JorgeMarinN/TORepo_IHPSept2025_FloatingGateDCDC/README.md

# TORepo_IHPSept2025_FloatingGateDCDC
Floating gate DCDC project for the Sept. 2025 IHP tapeout
