JorgeMarinN/TORepo_IHPSept2025_FloatingGateDCDC/Documentos/3.- Thin_Gate_Oxide_CMOS_DC-DC_Buck_Converter_with_Floating_Gate_Drivers (1).pdf

# Thin gate oxide CMOS DC-DC Buck converter with floating gate drivers

Joel Gak³

, Jorge Marin¹,2

, Nicolas Gonzalez³

, Daniel Arevalos¹

,Nicolas Calarco³

, Matias Miguez³
,
Alfonso Cortes¹

, Vicente Osorio¹

, Mario Romero¹

, Christian A. Rojas¹,2
1Department of Electronic Eng., Universidad Tecnica Federico Santa Maria, Valparaiso, Chile,
2Advanced Center of Electrical and Electronics Engineering, Universidad Tecnica Federico Santa Mar ´ | ´ıa,
{jorge.marinn,christian.rojas}@usm.cl
3Engineering Department, Universidad Catolica del Uruguay, Montevideo, Uruguay, ´ | {jgak,mmiguez}@ucu.edu.uy

Abstract—This document is a model and instructions for LATEX.
This work focuses on the design of a CMOS DC-DC buck converter targeting input voltages higher than the limited gatesource voltage common in thin oxide technology. This is enabled by driving the power device gates using fully integrated circuitry which allows floating voltages in the high-side device using bootstrapping. The gate driver has been fully characterized in simulation, showing low to high an high to low times below 12ns. The bootstrapped level shifter has been integrated together with a dual-NMOS half bridge using the Skywater 130nm Opensource CMOS technology. Simulations show a peak efficiency of 91% at 38.2mA current load for a 10V to 3.3V DC-DC conversion, extending the input voltage range previously reported in this technology by 2X.
Index Terms—Thin Oxide, CMOS, floating gate
I. INTRODUCTION

DC-DC converters are an essential component of many modern electronic devices like, smartphones, laptops, and tablets. Their importance is increased when of the grid edge computing devices for Internet of thing applications are taken into account. In power management systems, DC-DC converters are used, switching from one DC voltage level to another, which is often necessary to power different components in a device or to match the voltage requirements of a load to the available power supply [1]. DC-DC converters can be implemented using a variety of technologies, but CMOS technology is becoming increasingly popular for this application. CMOS transistors have a number of advantages for DC-DC converters, such as high switching speed, low power consumption, ability to withstand high voltages (HV) in source and drain without complex extra process and high-density integration allowing high complex digital to be integrated beside HV circuits [2]. In Fig.1 a single leg NMOS DC-DC Buck converter is shown, transistors M1,2 are used as power switches to transfer energy to inductance L0 where the switching is performed by the drivers Driv1, −Driv2. In order to reduce as much as possible the rON of the transistor M1,2, VGS must be as high as possible without breaking (VMAX). In case of transistor M1 the ideal switching voltage will be just VMAX but for M2 the

The authors would like to thanks ANII for the post doctoral funding of Nicolas Calarco project number PD NAC 2021 1 168336. Supported by the Chilean research grant ANID/FONDECYT Regular/1210757 and by AC3E (ANID/BASAL/FB0008).

switching voltage will be VMAX + VS1, which could causes gate rupture in standard CMOS technologies due to thin gate oxide leading to transistor failure.
Even though in some technologies it is possible to fabricate CMOS transistors with thicker gate oxides, this is generally more expensive to fabricate and not generally available. This work addresses the challenge of using standard CMOS technology for DC-DC converters by using floating gate drivers. Floating gate drivers allow the gate of the high-side transistor to be switched relative to its source voltage, rather than relative to ground, as shown in Fig. 2, eliminating the need for a thick gate oxide on the high-side transistor [3].
This work is organized as follows: in section II the design of the floating gate driver is presented, followed by a discussion on DC-DC buck converter design application in section III. Section IV presents full system simulations of the proposed design and finally, in Section V presents the final conclusion.

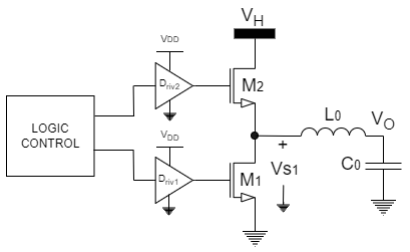
[picture p1: figure]

Fig. 1. Single leg NMOS DC-DC Buck converter. VMAX is always less than VDD.

II. FLOATING GATE DRIVER

In integrated CMOS synchronous buck converters, the high-side transistor has been historically built using a PMOS highvoltage device [4]. This eases the design effort by simplifying the driver structure and body biasing. However, using PMOS devices presents one implicit disadvantage that impacts the converter figures of merit; to achieve good efficiency the PMOS transistor must be wider than its NMOS counterpart. This in turn means that the power required by the transistor driver increases, reducing the performance of the system. If

2024 Argentine Conference on Electronics - CAE

979-8-3503-0508-1/24/$31.00 ©2024 IEEE | 120 | IEEE Catalog Number CFP24S41-ART
2024 Argentine Conference on Electronics (CAE) | 979-8-3503-0508-1/24/$31.00 ©2024 IEEE | DOI: 10.1109/CAE59785.2024.10487162

Authorized licensed use limited to: Universidad Tecnica Federico Santa Maria. Downloaded on December 16,2024 at 01:52:42 UTC from IEEE Xplore. Restrictions apply.

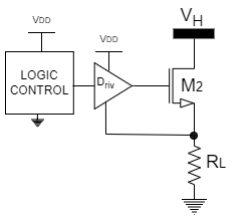
[picture p2: figure]

Fig. 2. Relative to source driving

a NMOS device is used, a reduced transistor size can be selected, and thus improve the overall efficiency and area. But this requires a special type of driver that can command it as a switch while protecting its thin oxide gate. These types of drivers provide floating gate operation with respect to the transistor source: when the switch is closed, the gate voltage rises above the source voltage by more than VT and less than VMAX. On the other hand, when the switch must be open, the gate voltage tracks the transistor source, effectively shutting down the device conduction. In Fig. 3 a schematic of the proposed driver, similar to [3], is presented.
To drive the power transistor MPW R transistors M1,2 form an inverter that is controlled by a floating latch L1. Transistors M1,2 must be carefully sized to comply with time requirements (generally MPW R is a large transistor). Both the inverter and latch negative supply are referenced to the transistor source (VSOURCE) and powered by VBOOT . A bootstrap capacitor CBOOT , maintains the voltage VBOOT, storing the energy required for switching while tracking source voltage changes. The voltage difference VBOOT − VSOURCE should be close to VMAX, powering the latch and inverter. When the switch is closed, some of the charge stored in CBOOT will be redistributed from the capacitor to the gate of the NMOS transistor MPW R; which will reduce VBOOT . To ensure that the voltage drop does not compromise its on-resistance and the latch operation, this reduction cannot be to high. In this work, the bootstrap capacitor was selected 10 times larger than the estimated gate source capacitance (CGS) of MPW R. The nature of the buck converter switching node provides a refresh path for the boot capacitor charge, ensuring proper operation. This happens when the low-side is active, and one of the capacitor plates is grounded, making it possible to draw current from the low-voltage source. Charge is blocked back when the capacitor is just connected by a diode (D1). Operating the latch requires a high voltage level shifter (LEVEL SHIFTING on Fig. 3), to translate signals from the low to high voltage domain (SHORT PULSE GENERATOR on Fig. 3) without breaking the floating transistors’ maximum VGS rating. The main idea is to drive the latch set and reset signals from VH to VH − Vlatch, using pulsed inputs and an relatively large bias current IBias to drive the set and reset nodes. Positive feedback ensures that the idle signal is quickly set to a state that won’t affect the latch operation.

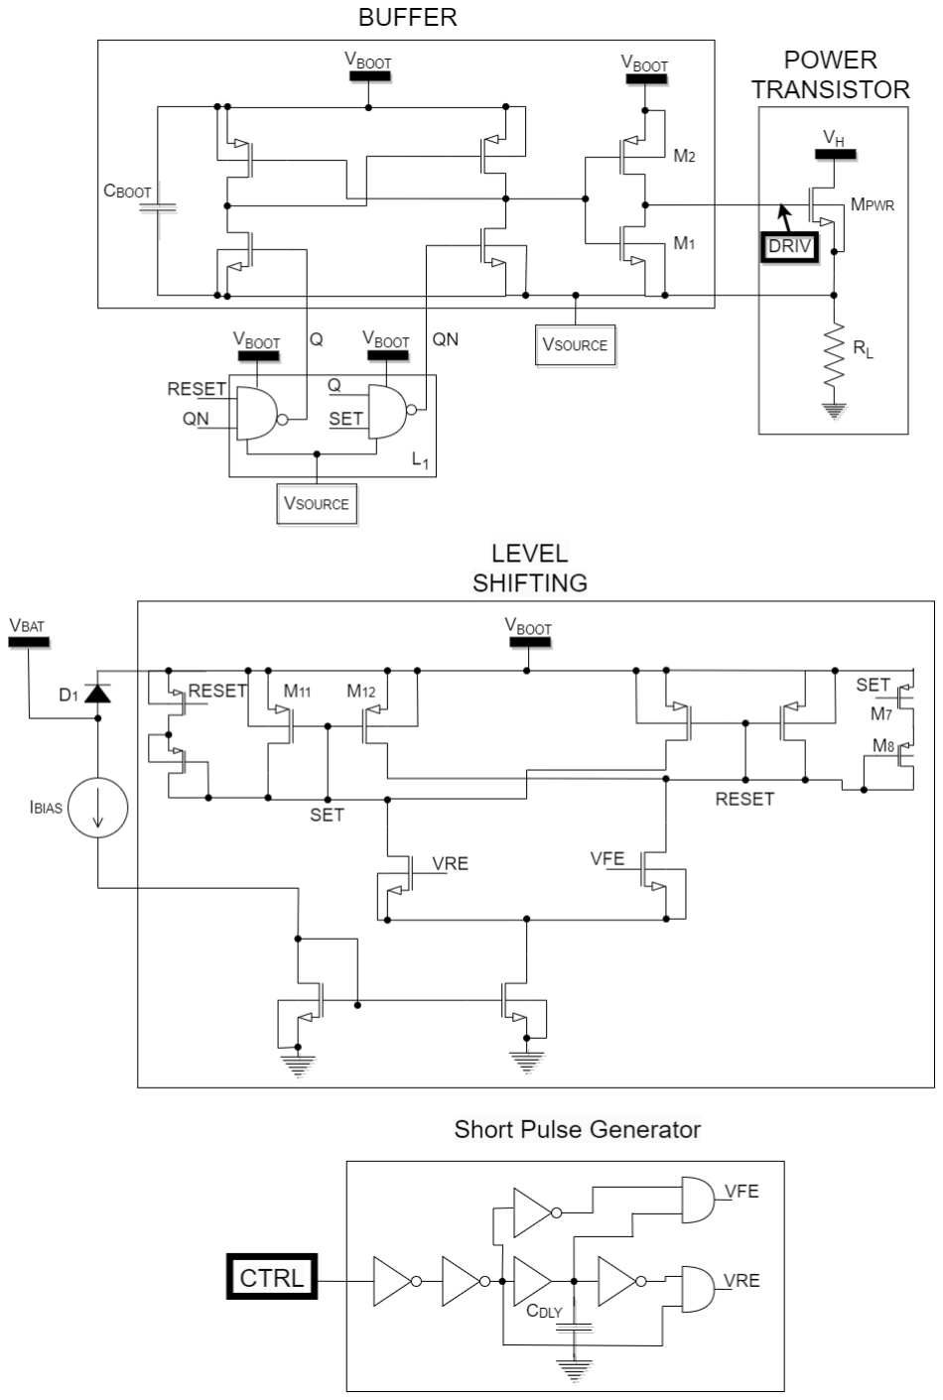
[picture p3: figure]

Fig. 3. Floating Gate Diver Schematic

For a Set (turn-on) operation, VRE node is pulsed high, and IBias starts to flow through that branch. First discharging SET parasitic capacitance. As SET drops, M11 starts conducting a fraction of IBias which is then mirrored by M12 into the RESET node. As RESET is now in a high impedance floating node, the current charges the node until it reaches the bootstrap voltage VH. This in turn fully disengages the latch RESET signal. M11 must be a transistor long enough so that its VDS drop while conducting IBias is enough to trigger the latch and must be dimensioned accordingly. Transistors M11/M12 multiplication factor depends on technology, parasitic and the latch parameters, which should be derived through design space exploration.
VRE pulse should be long enough for IBias to discharge the SET node, but not too large so that M11 wastes the capacitor charge to ground when the latch has already tripped. Trimming IBias or the pulse width can be used to improve efficiency in operation speed and switch on resistance.
Transistors M7,8 are implemented to account for large slewing in the high voltage node while the opposite branch is operated. In case of a large slew rate, the floating node could
979-8-3503-0508-1/24/$31.00 ©2024 IEEE | 121 | IEEE Catalog Number CFP24S41-ART

lag behind, which can compromise the transistors or glitch the latch activation. When SET is active M7 also is, leaving M8 as a diode-connected transistor to charge the RESET node to VHIGH even when there is no current flowing through M12. In Fig. 4 a transient simulation of the designed floating gate driver, for a VBAT = 5V , a short pulse generation power supply of 1.8V , VH = 10V and switching frequency of 10MHz. It can be seen that floating gate driver works as expected, the DRIV signal follows VSOURCE when CT RL is low and it goes one VBOOT = VBAT − VD1 above VSOURCE when CT RL is on high state, the low to high an high to low times are below 12ns.

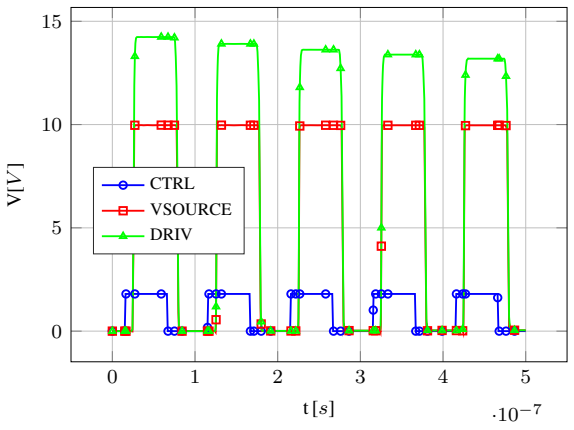
[picture p4: figure]
CTRL; VSOURCE; DRIV

Fig. 4. Transient simulation of the designed floating gate driver.

The layout of the floating-gate driver is shown in Fig. 5. Total area is 2489µm²

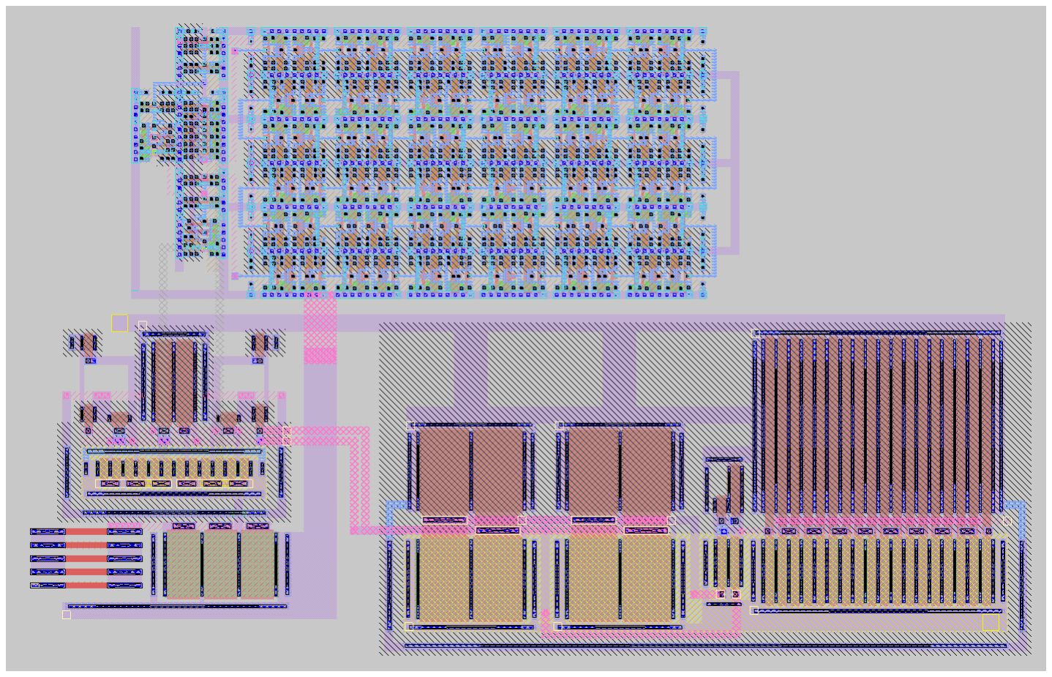
[picture p5: figure]

Fig. 5. Bootstrapped level shifter full layout.

III. DC-DC BUCK CONVERTER
In Fig.6, the NMOS single leg DC-DC buck converter standard topology used in this work is shown. It is used to perform the a down conversion from an input voltage (VH = 10V ) to a low output voltage (VOUT = 3.3V ). The circuit consists of two power NMOS transistors M1,2 and two different gate drivers where Driv1 is a standard level shifter design using the methodology presented in [5] and Driv2 a floating gate driver like the the one designed in the prior section, with (VM ID = 5V ), and a control logic designed with standard cells (VDD = 1.8V ) and a LC output filter LO and CO.
In order to design the DC-DC several things must be taken into account: the power source voltage VH, output voltage VOUT , load current (in this case ILOAD = 75mA) and switching frequency fsw in order to determine over all efficiency. The static and dynamic power losses given by (1) and (2), were PS and PD are the static (conduction) and dynamic (switching) power losses, respectively, and RONM1,2
are the
on state resistance of power transistors M1,2, respectively [6]. Equations (1) and (2) assumes 50% duty cycle and no dead time losses.

PS = (RONM1 + RONM2

) · ILOAD | (1)
PD = (CGGM1 + CGGM2

) · V

2
OUT · fSW | (2)

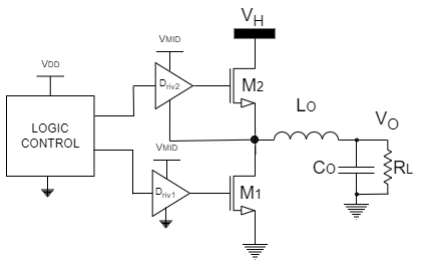
[picture p6: figure]

Fig. 6. The DC-DC Buck converter proposed on this work.

Layout generation can be an very time consuming task done by a highly trained individual; in order to reduce it, an automated layout generator flow which includes the prior defined specifications, and that uses standard and special transistors, border and corner cells, and guard rings was developed and used. The layout of the DC-DC Buck converter is shown in Fig. 7, yielding a total silicon area of 0.27mm²
, including the
guard ring structures. In Table I, a summary of the dimensions of the different subsystems is presented.

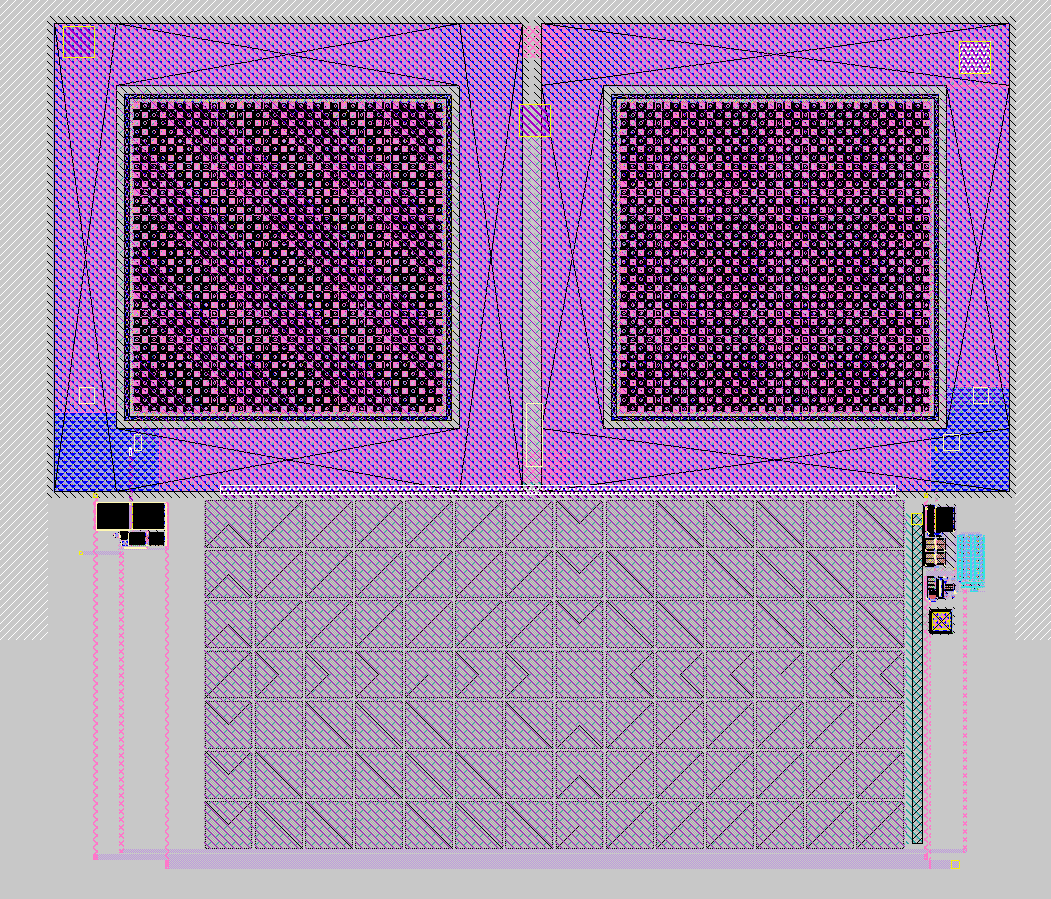
[picture p7: figure]

Fig. 7. Generated DC-DC Buck converter layout.

979-8-3503-0508-1/24/$31.00 ©2024 IEEE | 122 | IEEE Catalog Number CFP24S41-ART

IV. FULL SYSTEM SIMULATIONS
All the circuits in this work have been designed, implemented and simulated using the open-source PDK Skywater 130nm CMOS technology with open-source analog design tools. In this section, the main simulated results are shown and analyzed. To test the performance of the DC-DC architecture, the efficiency has been simulated for different load current values at a switching frequency of fSW = 100kHz, as shown in Fig. 8 as efficiency curve with (EF FLS) and without (EF FNOLS) the floating gate driver. For the simulations, the input voltage VH = 10V and output VOUT = 3.3V , while the switching pulses were provided in an open-loop fashion, after being derived from system-level simulations. The peak efficiency is 91% at ILOAD = 38.2mA.
The transient simulation is shown in Fig. 9 and 10, showing a good startup behaviour and a ripple below 15mV, respec-

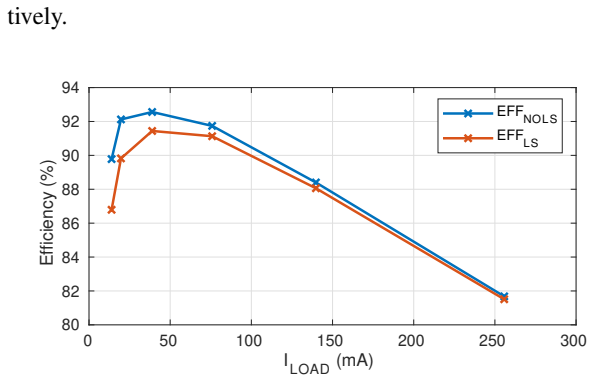
[picture p8: figure]
tively.; ILOAD (mA); Efficiency (%); EFFNOLS; EFFLS

Fig. 8. DC-DC Buck converter simulated efficiency for different load current, with (EF FLS) and without (EF FNOLS) the floating gate driver for fSW = 100kHz.

TABLE I
SUBSYSTEMS DIMENSIONS
Subsytem | Width[µm]×Length[µm] | Area[µm² ]
Power Stage | 616x306 | 188496
Boot Capacitor | 447×223 | 100
Boot Diode | 17×17 | 289
Driver | 100×21 | 2100

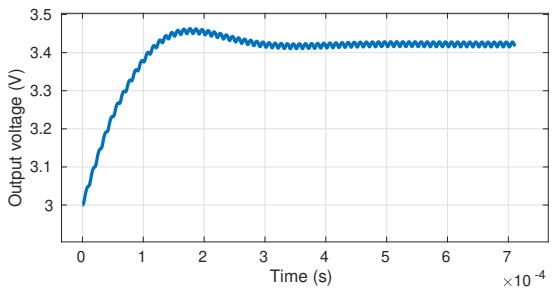
[picture p9: figure]
Time (s); Output voltage (V)

Fig. 9. DC-DC Buck converter simulated start-up transient simulation for load current equal to 75mA and fSW = 100kHz.

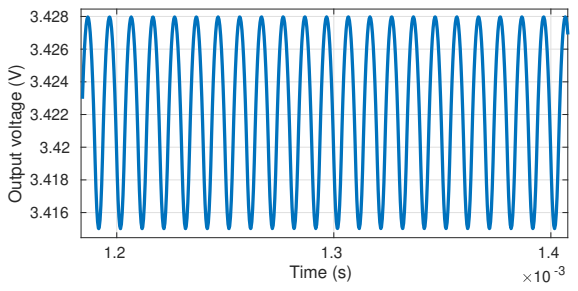
[picture p10: figure]
Time (s); Output voltage (V)

Fig. 10. DC-DC Buck converter steady state simulation for load current equal to 75mA and fSW = 100kHz, showing the ripple value which is below 15mV.

V. CONCLUSIONS
In this paper, the design, simulation and the automated layout, in Skywater 130nm CMOS technology, of a thin gate oxide CMOS DC-DC Buck converter with floating gate drivers was presented. The gate driver has been simulated for the required working conditions, showing low to high an high to low times below 12ns. The bootstrapped level shifter has been integrated together with a dual-NMOS half bridge showing a peak efficiency of 91% at 38.2mA current load for a 10V to 3.3V DC-DC conversion, extending the input voltage range previously reported in this technology [7] by factor of two.

REFERENCES

[1] C. Fuentes, B. Allongue, S. Buso, G. Blanchot, F. Faccio, S. Michelis,
S. Orlandi, and G. Spiazzi, “Power distribution with custom dc-dc converters for slhc trackers,” in 2009 IEEE Nuclear Science Symposium Conference Record (NSS/MIC), 2009, pp. 1300–1305.
[2] R. Garcia-Ramirez, A. Chacon-Rodriguez, R. Molina-Robles, R. Castro-Gonzalez, E. Solera-Bolanos, G. Madrigal-Boza, M. Oviedo-Hernandez,
D. Salazar-Sibaja, D. Sanchez-Jimenez, M. Fonseca-Rodriguez, J. Arrieta-Solorzano, R. Rimolo-Donadio, A. Arnaud, M. Miguez, and J. Gak, “Siwa: A custom risc-v based system on chip (soc) for low power medical applications,” Microelectronics Journal, vol. 98, p. 104753, 2020.
[3] Z. Liu, L. Cong, and H. Lee, “Design of on-chip gate drivers with powerefficient high-speed level shifting and dynamic timing control for highvoltage synchronous switching power converters,” IEEE Journal of Solid-State Circuits, vol. 50, no. 6, pp. 1463–1477, 2015.
[4] G. A. Rincon-Mora, ´ | Switched Inductor Power IC Design. | Springer,
2023.
[5] J. Gak, M. Miguez, and A. Arnaud, “Cmos level shifters from 0 to 18 V output,” Analog Integr. Circuits Signal Process., vol. 107, no. 3,
p. 617–628, jun 2021.
[6] G. V. Pique and E. Alarc ´ | on, ´ | CMOS Integrated Switching Power Con-
verters: A Structured Design Approach. | Springer Science & Business
Media, 2011.
[7] J. Marin, J. Gak, A. Cortes, N. Calarco, A. Oliva, E. Lindstrom,
M. Miguez, A. Falcon, N. Osterman, and C. A. Rojas, “Integrated three- ´ level flying capacitor dc-dc buck converter for cubesat applications,” in 2023 Argentine Conference on Electronics (CAE), 2023, pp. 90–95.
979-8-3503-0508-1/24/$31.00 ©2024 IEEE | 123 | IEEE Catalog Number CFP24S41-ART
