JorgeMarinN/TORepo_IHPSept2025_FloatingGateDCDC/Documentos/Boceto_Layout.pdf

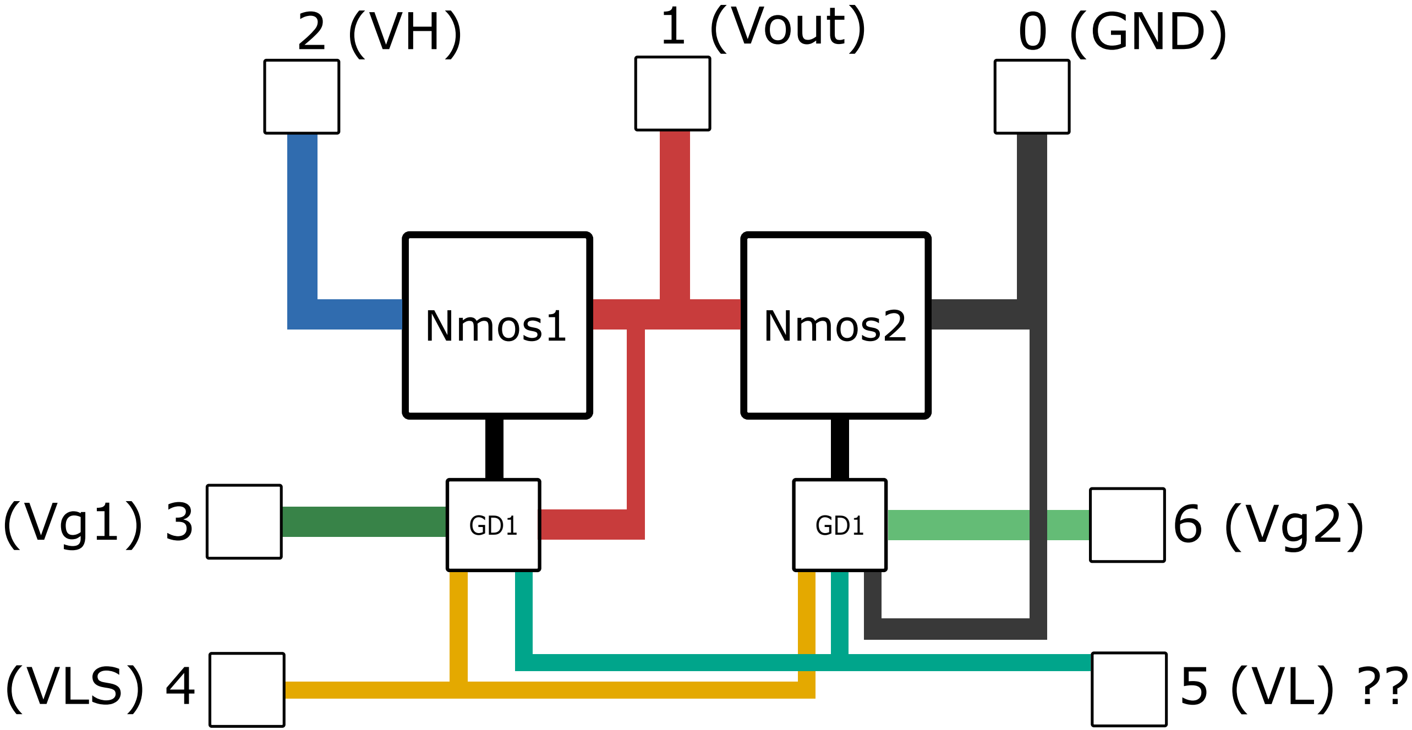
[picture p11: figure]
1 (Vout); 0 (GND); (VLS) 4; Nmos1; Nmos2
