JorgeMarinN/TORepo_IHPSept2025_FloatingGateDCDC/Documentos/Esquematico_DC_DC.pdf

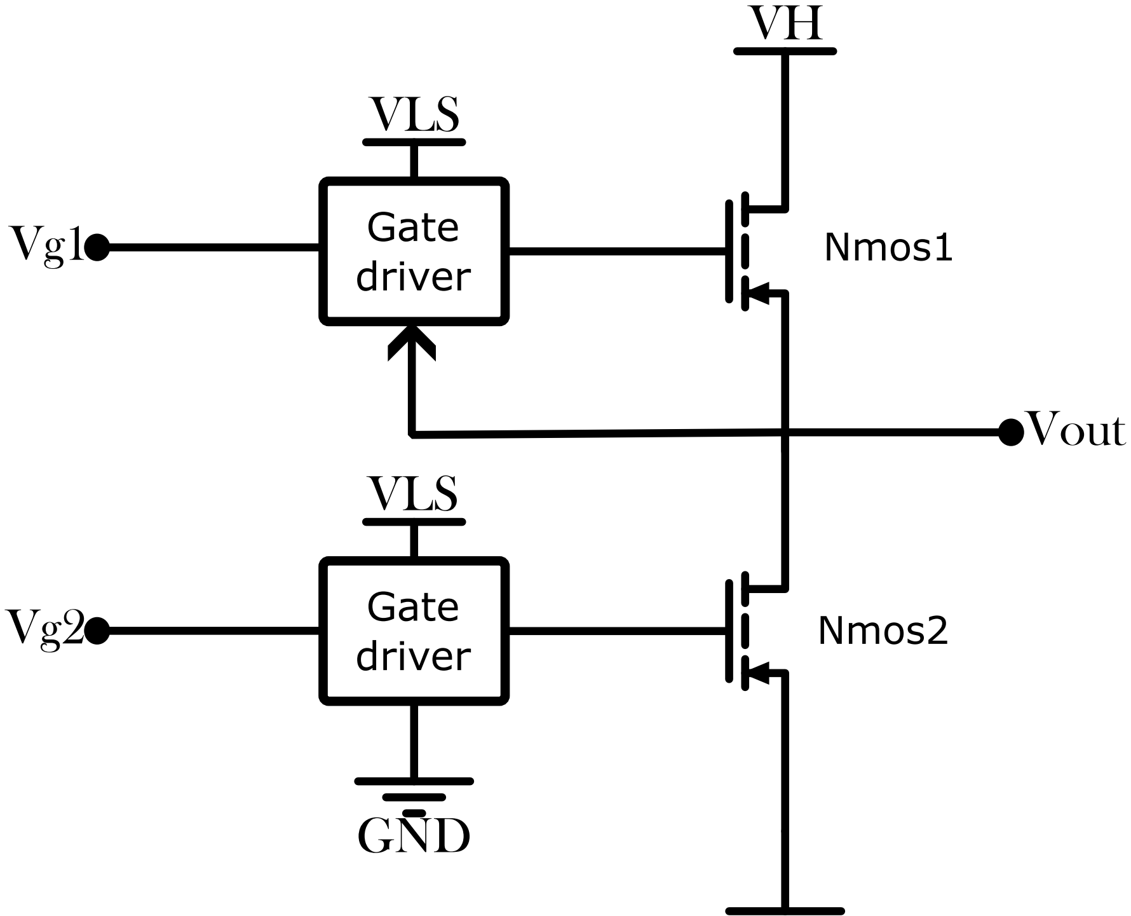
[picture p12: figure]
VLS; Vout; GND; Gate driver; Nmos1; Nmos2

GND
